MYHealer/wyu-jcalendar/assets/img/buymeacoffee.jpg

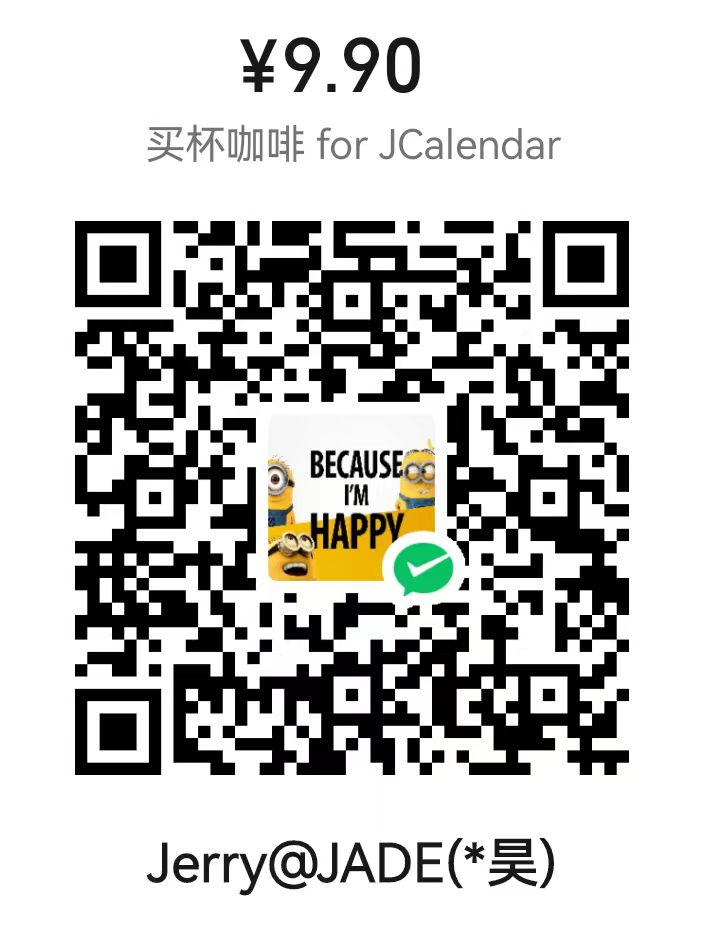
assets/img/buymeacoffee.jpg
