MYHealer/wyu-jcalendar/assets/img/likeit.jpg

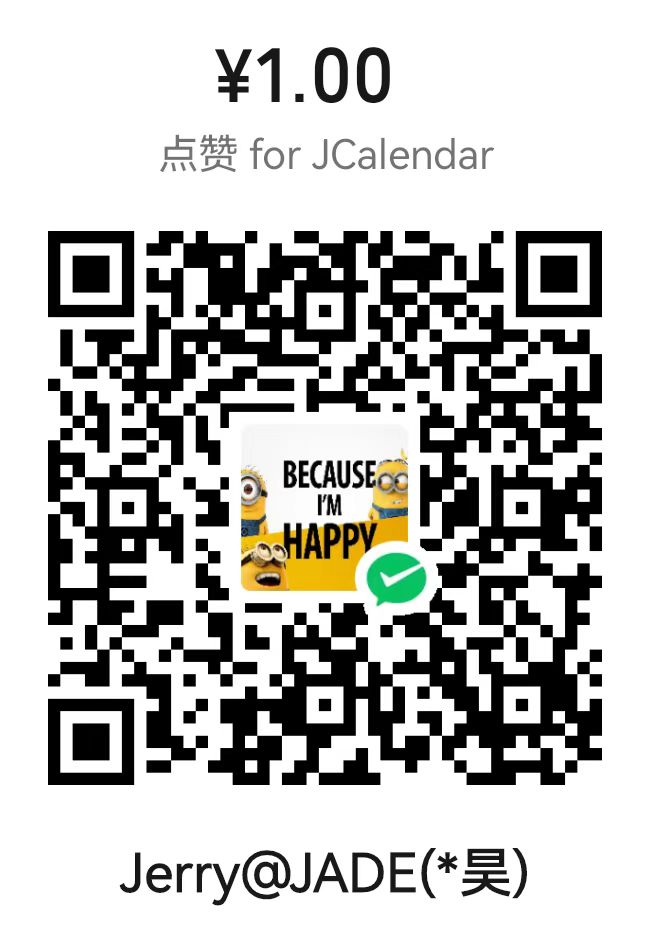
assets/img/likeit.jpg
