MYHealer/wyu-jcalendar/assets/img/LOLIN32_Lite.png

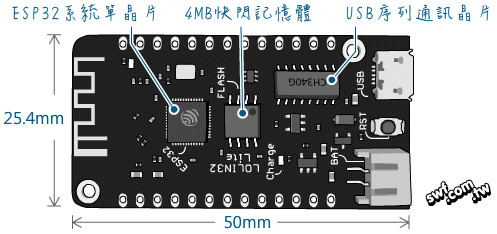
assets/img/LOLIN32_Lite.png
