MYHealer/wyu-jcalendar/assets/file/E-ink box2 v22.3mf

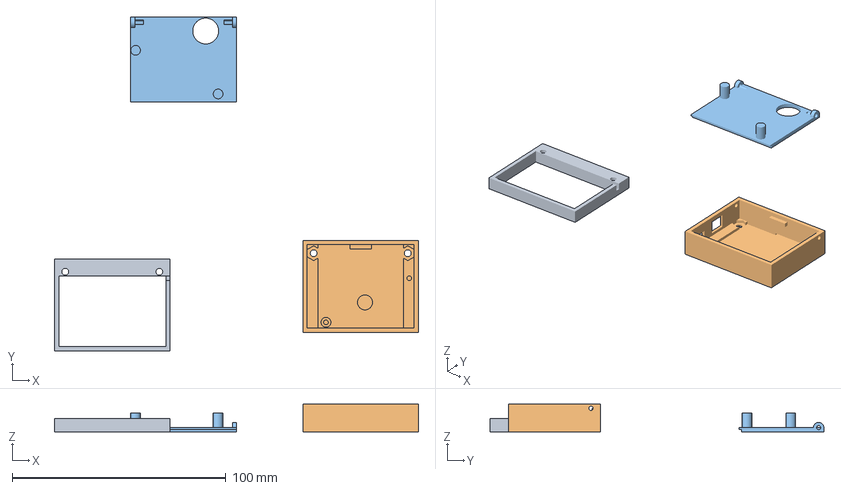
[picture p8: CAD file, 2026-05-20]
assets/file/E-ink box2 v22.3mf
170.1 x 156.0 x 13.0 mm
零部件3
零部件1
实体1.stl
