MYHealer/wyu-jcalendar/src/screen_ink.cpp

#include "screen_ink.h"


#include <weather.h>
#include <API.hpp>
#include "holiday.h"
#include "nongli.h"

#include "battery.h"
int voltage;

#include <_preference.h>

#include <U8g2_for_Adafruit_GFX.h>
#include <GxEPD2_3C.h>
#include "GxEPD2_display_selection_new_style.h"

#include "font.h"
#define ROTATION 0

#include "wiring.h"
GxEPD2_DISPLAY_CLASS<GxEPD2_DRIVER_CLASS, GxEPD2_DRIVER_CLASS::HEIGHT> display(GxEPD2_DRIVER_CLASS(/*CS=D8*/ SPI_CS, /*DC=D3*/ SPI_DC, /*RST=D4*/ SPI_RST, /*BUSY=D2*/ SPI_BUSY));
U8G2_FOR_ADAFRUIT_GFX u8g2Fonts;

#define FONT_TEXT u8g2_font_wqy16_t_gb2312 // 224825bytes，最大字库（天气描述中“霾”，只有此字库中有）
#define FONT_SUB u8g2_font_wqy12_t_gb2312 // 次要字体，u8g2最小字体
const String week_str[] = { "日", "一", "二", "三", "四", "五", "六" };
// const String tg_str[] = { "甲", "乙", "丙", "丁", "戊", "己", "庚", "辛", "壬", "癸" };            // 天干
// const String dz_str[] = { "子", "丑", "寅", "卯", "辰", "巳", "午", "未", "申", "酉", "戌", "亥" }; // 地支
// const String sx_str[] = { "鼠", "牛", "虎", "兔", "龙", "蛇", "马", "羊", "猴", "鸡", "狗", "猪" }; // 生肖
const String nl10_str[] = { "初", "十", "廿", "卅" }; // 农历十位
const String nl_str[] = { "十", "一", "二", "三", "四", "五", "六", "七", "八", "九", "十" }; // 农历个位
const String nl_mon_str[] = { "", "正", "二", "三", "四", "五", "六", "七", "八", "九", "十", "冬", "腊" }; // 农历首位

int _screen_status = -1;
int _calendar_status = -1;
String _cd_day_label;
String _cd_day_date;
String _tag_days_str;
int _week_1st;
int lunarDates[31];
int jqAccDate[24]; // 节气积累日

const int jrLength = 11;
const int jrDate[] = { 101, 214, 308, 312, 501, 504, 601, 701, 801, 910, 1001, 1224, 1225 };
const String jrText[] = { "元旦", "情人节", "妇女节", "植树节", "劳动节", "青年节", "儿童节", "建党节", "建军节", "教师节", "国庆节", "平安夜", "圣诞节" };

int _si_type = 0;
String _study_schedule;


struct tm tmInfo = { 0 }; // 日历显示用的时间

struct
{
    int16_t topX;
    int16_t topY;
    int16_t topW;
    int16_t topH;

    int16_t tX;
    int16_t tY;
    int16_t tW;
    int16_t tH;

    int16_t yearX;
    int16_t yearY;
    int16_t weekX;
    int16_t weekY;

    int16_t lunarYearX;
    int16_t lunarYearY;
    int16_t lunarDayX;
    int16_t lunarDayY;
    int16_t cdDayX;
    int16_t cdDayY;

    int16_t statusX;
    int16_t statusY;
    int16_t statusW;
    int16_t statusH;

    int16_t weatherX;
    int16_t weatherY;
    int16_t weatherW;
    int16_t weatherH;

    int16_t headerX;
    int16_t headerY;
    int16_t headerW;
    int16_t headerH;

    int16_t daysX;
    int16_t daysY;
    int16_t daysW;
    int16_t daysH;
    int16_t dayW;
    int16_t dayH;
} static calLayout;

TaskHandle_t SCREEN_HANDLER;

void init_cal_layout_size() {
    calLayout.topX = 0;
    calLayout.topY = 0;
    calLayout.topW = 180;
    calLayout.topH = 60;

    calLayout.yearX = 10;
    calLayout.yearY = calLayout.topH - 28;
    calLayout.weekX = 10;
    calLayout.weekY = calLayout.topH - 5;

    calLayout.lunarYearX = calLayout.topX + calLayout.topW + 15;
    calLayout.lunarYearY = calLayout.yearY / 2;
    calLayout.lunarDayX = calLayout.topX + calLayout.topW + 15;
    calLayout.lunarDayY = calLayout.yearY;

    calLayout.cdDayX = 0;
    calLayout.cdDayY = calLayout.topH - 5;

    calLayout.tX = calLayout.topX + calLayout.topW;
    calLayout.tY = calLayout.topY;
    calLayout.tW = 60;
    calLayout.tH = calLayout.topH / 2;

    calLayout.statusX = 300;
    calLayout.statusY = 0;
    calLayout.statusW = display.width() - calLayout.weatherX;
    calLayout.statusH = 14;

    calLayout.weatherX = 300;
    calLayout.weatherY = calLayout.topY;
    calLayout.weatherW = display.width() - calLayout.weatherX;
    calLayout.weatherH = calLayout.topH;

    calLayout.headerX = calLayout.topX;
    calLayout.headerY = calLayout.topY + calLayout.topH;
    calLayout.headerW = display.width();
    calLayout.headerH = 20;

    calLayout.daysX = calLayout.topX;
    calLayout.daysY = calLayout.headerY + calLayout.headerH;
    calLayout.daysW = calLayout.headerW;
    calLayout.daysH = display.height() - calLayout.daysX;
    calLayout.dayW = 56;
    calLayout.dayH = 44;
}

void draw_cal_header() {
    uint16_t color;

    u8g2Fonts.setFont(FONT_TEXT);
    u8g2Fonts.setFontMode(1);
    u8g2Fonts.setFontDirection(0);
    u8g2Fonts.setForegroundColor(GxEPD_WHITE);
    int16_t daysMagin = 4;

    for (int i = 0; i < 7; i++) {
        if ((i + _week_1st) % 7 == 0 || (i + _week_1st) % 7 == 6) {
            color = GxEPD_RED;
        } else {
            color = GxEPD_BLACK;
        }
        // header background
        if (i == 0) {
            display.fillRect(0, calLayout.headerY, (display.width() - 7 * calLayout.dayW) / 2, calLayout.headerH, color);
        } else if (i == 6) {
            display.fillRect((display.width() + 7 * calLayout.dayW) / 2, calLayout.headerY, (display.width() - 7 * calLayout.dayW) / 2, calLayout.headerH, color);
        }
        display.fillRect((display.width() - 7 * calLayout.dayW) / 2 + i * calLayout.dayW, calLayout.headerY, calLayout.dayW, calLayout.headerH, color);

        // header text
        u8g2Fonts.drawUTF8(calLayout.headerX + daysMagin + (calLayout.dayW - u8g2Fonts.getUTF8Width(week_str[i].c_str())) / 2 + i * calLayout.dayW, calLayout.headerY + calLayout.headerH - 3, week_str[(i + _week_1st) % 7].c_str());
    }
}

uint16_t todayColor = GxEPD_BLACK;
String todayLunarYear;
String todayLunarDay;

// 更新年份
void draw_cal_year(bool partial) {
    if (partial) {
        display.setPartialWindow(calLayout.topX, calLayout.topY, calLayout.topW + calLayout.tW, calLayout.topH);
        display.firstPage();
        display.fillScreen(GxEPD_WHITE);
    }

    // 日期
    u8g2Fonts.setFontMode(1);
    u8g2Fonts.setFontDirection(0);
    u8g2Fonts.setForegroundColor(todayColor);
    u8g2Fonts.setBackgroundColor(GxEPD_WHITE);
    u8g2Fonts.setCursor(calLayout.yearX, calLayout.yearY);
    u8g2Fonts.setFont(u8g2_font_fub25_tn);
    u8g2Fonts.print(String(tmInfo.tm_year + 1900).c_str());
    u8g2Fonts.setFont(FONT_TEXT);
    u8g2Fonts.setForegroundColor(GxEPD_BLACK);
    u8g2Fonts.print("年");
    u8g2Fonts.setFont(u8g2_font_fub25_tn);
    u8g2Fonts.setForegroundColor(todayColor);
    u8g2Fonts.print(String(tmInfo.tm_mon + 1).c_str());
    u8g2Fonts.setFont(FONT_TEXT);
    u8g2Fonts.setForegroundColor(GxEPD_BLACK);
    u8g2Fonts.print("月");
    u8g2Fonts.setFont(u8g2_font_fub25_tn);
    u8g2Fonts.setForegroundColor(todayColor);
    u8g2Fonts.printf(String(tmInfo.tm_mday).c_str());
    u8g2Fonts.setFont(FONT_TEXT);
    u8g2Fonts.setForegroundColor(GxEPD_BLACK);
    u8g2Fonts.print("日");

    calLayout.lunarYearX = u8g2Fonts.getCursorX() + 10;
    calLayout.lunarDayX = u8g2Fonts.getCursorX() + 10;

    // 第几周
    u8g2Fonts.setFont(FONT_TEXT);
    u8g2Fonts.setFontMode(1);
    u8g2Fonts.setFontDirection(0);
    u8g2Fonts.setForegroundColor(todayColor);
    u8g2Fonts.setCursor(calLayout.weekX, calLayout.weekY);
    char week_num[8];
    strftime(week_num, sizeof(week_num), "%V", &tmInfo); // 国际标准（ISO 8601）‌：以周一作为每周起始日
    u8g2Fonts.printf("第%s周", week_num);
    calLayout.cdDayX = u8g2Fonts.getCursorX(); // update cd day X;

    // 今日农历年份，e.g. 乙巳年 蛇
    // 如果农历月份小于公历月份，那么说明是上一年
    u8g2Fonts.setCursor(calLayout.lunarYearX, calLayout.lunarYearY);
    u8g2Fonts.setFont(FONT_SUB);
    u8g2Fonts.setFontMode(1);
    u8g2Fonts.setFontDirection(0);
    u8g2Fonts.setForegroundColor(GxEPD_BLACK);
    u8g2Fonts.print(todayLunarYear);

    // 今日农历日期
    u8g2Fonts.setCursor(calLayout.lunarDayX, calLayout.lunarDayY);
    u8g2Fonts.setFont(FONT_SUB);
    u8g2Fonts.setForegroundColor(GxEPD_BLACK);
    if (!todayLunarDay.isEmpty()) {
        u8g2Fonts.print(todayLunarDay);
    } else {
        u8g2Fonts.setFont(FONT_TEXT);
        u8g2Fonts.print(("星期" + week_str[tmInfo.tm_wday]).c_str());
    }

    // 特殊日期
    // draw_special_day();

    if (partial) {
        display.nextPage();
    }
}

void draw_cal_days(bool partial) {
    if (partial) {
        display.setPartialWindow(calLayout.daysX, calLayout.daysY, calLayout.daysW, calLayout.daysH);
        display.firstPage();
        display.fillScreen(GxEPD_WHITE);
    }

    u8g2Fonts.setFontMode(1);
    u8g2Fonts.setFontDirection(0);
    u8g2Fonts.setForegroundColor(GxEPD_BLACK);

    size_t totalDays = 30; // 小月
    int monthNum = tmInfo.tm_mon + 1;
    if (monthNum == 1 || monthNum == 3 || monthNum == 5 || monthNum == 7 || monthNum == 8 || monthNum == 10 || monthNum == 12) { // 大月
        totalDays = 31;
    }
    if (monthNum == 2) {
        if ((tmInfo.tm_year + 1900) % 4 == 0
            && (tmInfo.tm_year + 1900) % 100 != 0
            || (tmInfo.tm_year + 1900) % 400 == 0) {
            totalDays = 29; // 闰二月
        } else {
            totalDays = 28; // 二月
        }
    }

    // 计算本月第一天星期几
    int wday1 = (36 - tmInfo.tm_mday + tmInfo.tm_wday) % 7;
    // 计算本月第一天是全年的第几天（0～365）
    int yday1 = tmInfo.tm_yday - tmInfo.tm_mday + 1;

    // 确认哪些日期需要打tag
    char tags[31] = { 0 };
    int indexBegin = 0;
    while (_tag_days_str.length() >= (indexBegin + 9)) {
        String y = _tag_days_str.substring(indexBegin, indexBegin + 4);
        String m = _tag_days_str.substring(indexBegin + 4, indexBegin + 6);
        String d = _tag_days_str.substring(indexBegin + 6, indexBegin + 8);
        char t = _tag_days_str.charAt(indexBegin + 8);

        if ((y.equals(String(tmInfo.tm_year + 1900)) || y.equals("0000")) && (m.equals(String(tmInfo.tm_mon + 1)) || m.equals("00"))) {
            tags[d.toInt()] = t;
        }

        // Serial.printf("Format: %s, %s, %s, %c\n", y.c_str(), m.c_str(), d.c_str(), t);

        indexBegin = indexBegin + 9;
        while (indexBegin < _tag_days_str.length() && (_tag_days_str.charAt(indexBegin) < '0' || _tag_days_str.charAt(indexBegin) > '9')) { // 搜索字符串直到下个字符是0-9之间的
            indexBegin++;
        }
    }

    Holiday _holiday;
    Preferences pref;
    pref.begin(PREF_NAMESPACE);
    size_t holiday_size = pref.getBytesLength(PREF_HOLIDAY);
    if (holiday_size > 0) {
        pref.getBytes(PREF_HOLIDAY, &_holiday, holiday_size);
    }
    pref.end();

    if (_holiday.year != tmInfo.tm_year + 1900 || _holiday.month != tmInfo.tm_mon + 1) {
        _holiday = {};
    }

    int jqIndex = 0;
    int jrIndex = 0;
    int shiftDay = (wday1 - _week_1st) >= 0 ? 0 : 7;
    for (size_t iDay = 0; iDay < totalDays; iDay++) {
        uint8_t num = wday1 + iDay - _week_1st + shiftDay; // 根据每周首日星期做偏移
        uint8_t column = num % 7; //(0~6)
        uint8_t row = num / 7;    //(0~4)
        if (row == 5) row = 0;
        int16_t x = calLayout.daysX + 4 + column * 56;
        int16_t y = calLayout.daysY + row * 44;

        // 周六、日，字体红色
        uint16_t color;
        if ((wday1 + iDay) % 7 == 0 || (wday1 + iDay) % 7 == 6) {
            color = GxEPD_RED;
        } else {
            color = GxEPD_BLACK;
        }

        if (tmInfo.tm_year + 1900 == _holiday.year && tmInfo.tm_mon + 1 == _holiday.month) {
            uint8_t holidayIndex = 0;
            for (; holidayIndex < _holiday.length; holidayIndex++) {
                if (abs(_holiday.holidays[holidayIndex]) == (iDay + 1)) {
                    // 显示公休、调班logo和颜色
                    u8g2Fonts.setFont(u8g2_font_open_iconic_all_1x_t);
                    if (_holiday.holidays[holidayIndex] > 0) { // 公休
                        color = GxEPD_RED;
                        u8g2Fonts.setForegroundColor(color);
                        u8g2Fonts.setBackgroundColor(GxEPD_WHITE);
                        u8g2Fonts.drawUTF8(x + 44, y + 11, "\u006c");
                    } else if (_holiday.holidays[holidayIndex] < 0) { // 调班
                        color = GxEPD_BLACK;
                        u8g2Fonts.setForegroundColor(color);
                        u8g2Fonts.setBackgroundColor(GxEPD_WHITE);
                        u8g2Fonts.drawUTF8(x + 44, y + 11, "\u0064");
                    }
                    break;
                }
            }
        }
        u8g2Fonts.setForegroundColor(color); // 设置整体颜色
        u8g2Fonts.setBackgroundColor(GxEPD_WHITE);

        // 画日历日期数字
        u8g2Fonts.setFont(u8g2_font_fub17_tn); // u8g2_font_fub17_tn，u8g2_font_logisoso18_tn
        int16_t numX = x + (56 - u8g2Fonts.getUTF8Width(String(iDay + 1).c_str())) / 2;
        int16_t numY = y + 22;
        u8g2Fonts.drawUTF8(numX, numY, String(iDay + 1).c_str()); // 画日历日期

        // 画节气&节日&农历       
        String lunarStr = "";
        int lunarDate = lunarDates[iDay];
        int isLeapMon = lunarDate < 0 ? 1 : 0; // 闰月
        lunarDate = abs(lunarDate);
        int lunarMon = lunarDate / 100;
        int lunarDay = lunarDate % 100;

        bool isJq = false; // 是否节气
        int accDays0 = tmInfo.tm_yday + 1 - tmInfo.tm_mday; // 本月0日的积累日（tm_yday 从0开始，tm_mday从1开始, i从0开始）
        for (; jqIndex < 24; jqIndex++) {
            if (accDays0 + iDay + 1 < jqAccDate[jqIndex]) {
                break;
            }
            if (accDays0 + iDay + 1 == jqAccDate[jqIndex]) {
                lunarStr = String(nl_jq_text[jqIndex]);
                isJq = true;
                break;
            }
        }
        bool isJr = false; // 是否节日
        int currentDateNum = (tmInfo.tm_mon + 1) * 100 + iDay + 1;
        for (; jrIndex < jrLength; jrIndex++) {
            if (currentDateNum < jrDate[jrIndex]) {
                break;
            }
            if (currentDateNum == jrDate[jrIndex]) {
                lunarStr = jrText[jrIndex];
                isJr = true;
                break;
            }
        }
        if (!isJq && !isJr) { // 农历
            if (lunarDay == 1) {
                // 初一，显示月份
                lunarStr = (isLeapMon == 0 ? "" : "闰") + nl_mon_str[lunarMon] + "月";
            } else {
                if (lunarDay == 10) {
                    lunarStr = "初十";
                } else if (lunarDay == 20) {
                    lunarStr = "二十";
                } else if (lunarDay == 30) {
                    lunarStr = "三十";
                } else {
                    // 其他日期
                    lunarStr = nl10_str[lunarDay / 10] + nl_str[lunarDay % 10];
                }
            }
            if (lunarMon == 1 && lunarDay == 1) {
                lunarStr = "春节";
            } else if (lunarMon == 1 && lunarDay == 15) {
                lunarStr = "元宵节";
            } else if (lunarMon == 5 && lunarDay == 5) {
                lunarStr = "端午节";
            } else if (lunarMon == 7 && lunarDay == 7) {
                lunarStr = "七夕节";
            } else if (lunarMon == 8 && lunarDay == 15) {
                lunarStr = "中秋节";
            } else if (lunarMon == 9 && lunarDay == 9) {
                lunarStr = "重阳节";
            }
        }
        // 画节气/节日/农历文字
        u8g2Fonts.setFont(FONT_TEXT);
        u8g2Fonts.drawUTF8(x + (56 - u8g2Fonts.getUTF8Width(lunarStr.c_str())) / 2, y + 44 - 4, lunarStr.c_str());

        // 今日日期
        if ((iDay + 1) == tmInfo.tm_mday) { // 双线加粗
            todayColor = color;

            // 加框线
            display.drawRoundRect(x, y + 1, 56, 44, 4, GxEPD_RED);
            display.drawRoundRect(x + 1, y + 2, 54, 42, 3, GxEPD_RED);

            // 今日农历年份，e.g. 乙巳年 蛇
            // 如果农历月份小于公历月份，那么说明是上一年
            int tg = nl_tg(tmInfo.tm_year + 1900 - (lunarMon > (tmInfo.tm_mon + 1) ? 1 : 0));
            int dz = nl_dz(tmInfo.tm_year + 1900 - (lunarMon > (tmInfo.tm_mon + 1) ? 1 : 0));;
            todayLunarYear = String(nl_tg_text[tg]) + String(nl_dz_text[dz]) + "年 " + String(nl_sx_text[dz]);

            // 今日农历日期
            if (lunarDay == 10) {
                lunarStr = "初十";
            } else if (lunarDay == 20) {
                lunarStr = "二十";
            } else if (lunarDay == 30) {
                lunarStr = "三十";
            } else {
                // 其他日期
                lunarStr = nl10_str[lunarDay / 10] + nl_str[lunarDay % 10];
            }
            todayLunarDay = (isLeapMon == 0 ? "" : "闰") + nl_mon_str[lunarMon] + "月" + lunarStr;
        }

        // 画日期Tag
        const char* tagChar = NULL;
        if (tags[iDay + 1] == 'a') { //tag
            tagChar = "\u0042";
        } else if (tags[iDay + 1] == 'b') { // dollar
            tagChar = "\u0024";
        } else if (tags[iDay + 1] == 'c') { // smile
            tagChar = "\u0053";
        } else if (tags[iDay + 1] == 'd') { // warning
            tagChar = "\u0021";
        }
        if (tagChar != NULL) {
            u8g2Fonts.setBackgroundColor(GxEPD_WHITE);
            u8g2Fonts.setForegroundColor(GxEPD_RED);
            u8g2Fonts.setFont(u8g2_font_twelvedings_t_all);
            int iconX = numX - u8g2Fonts.getUTF8Width(tagChar) - 1; // 数字与tag间间隔1像素
            iconX = iconX <= (x + 3) ? (iconX + 1) : iconX; // 防止icon与今日框线产生干涉。
            int iconY = y + 15;
            u8g2Fonts.drawUTF8(iconX, iconY, tagChar);
        }

        // 画Calendar提示点
        /*
        Calendar* cal = weather_cal();
        for(int calIndex = 0; calIndex < cal->length; calIndex ++) {
            CalEvent event = cal->events[calIndex];
            if(event.dt_begin.substring(0, 4).toInt() == (tmInfo.tm_year + 1900)
            && event.dt_begin.substring(4, 6).toInt() == (tmInfo.tm_mon + 1)
            && event.dt_begin.substring(6, 8).toInt() == (iDay + 1)) {
                u8g2Fonts.setBackgroundColor(GxEPD_WHITE);
                u8g2Fonts.setForegroundColor(GxEPD_RED);
                u8g2Fonts.setFont(u8g2_font_siji_t_6x10);
                u8g2Fonts.drawUTF8(x + 42, y + 12, "\ue015");
            }
        }
        */
    }
}

// draw countdown-day info
void draw_cd_day(String label, String date) {
    if (label == NULL || date == NULL || label.length() == 0 || date.length() != 8) {
        Serial.print("Invalid countdown-day parameters.\n");
        return;
    }

    long d = atol(date.c_str());

    struct tm today = { 0 }; // 今日0秒
    today.tm_year = tmInfo.tm_year;
    today.tm_mon = tmInfo.tm_mon;
    today.tm_mday = tmInfo.tm_mday;
    today.tm_hour = 0;
    today.tm_min = 0;
    today.tm_sec = 0;
    time_t todayT = mktime(&today);

    struct tm someday = { 0 }; // 倒计日0秒
    someday.tm_year = d / 10000 - 1900;
    someday.tm_mon = d % 10000 / 100 - 1;
    someday.tm_mday = d % 100;
    someday.tm_hour = 0;
    someday.tm_min = 0;
    someday.tm_sec = 0;
    time_t somedayT = mktime(&someday);

    /*
    char buffer[80];
    strftime(buffer, 80, "%Y-%m-%d %H:%M:%S", &someday);
    Serial.printf("CD day: %s\n", buffer);
    */

    long diff = somedayT - todayT;
    if (diff < 0) return; // 倒计日已过

    int16_t beginX = calLayout.cdDayX;
    int16_t endX = calLayout.weatherX;
    int16_t y = calLayout.cdDayY;

    if (diff == 0) {
        String prefix = "今日 ";
        String suffix = " ！！！";
        u8g2Fonts.setFont(FONT_SUB);
        int16_t preWidth = u8g2Fonts.getUTF8Width(prefix.c_str());
        int16_t suffixWidth = u8g2Fonts.getUTF8Width(suffix.c_str());
        u8g2Fonts.setFont(FONT_SUB);
        int16_t labelWidth = u8g2Fonts.getUTF8Width(label.c_str());
        int16_t margin = (endX - beginX - preWidth - labelWidth - suffixWidth) / 2;

        u8g2Fonts.setCursor((margin > 0 ? margin : 0) + beginX, y); // 居中显示
        u8g2Fonts.setForegroundColor(GxEPD_BLACK);
        u8g2Fonts.setFont(FONT_SUB);
        u8g2Fonts.print(prefix.c_str()); // 今天
        u8g2Fonts.setForegroundColor(GxEPD_RED);
        u8g2Fonts.setFont(FONT_TEXT);
        u8g2Fonts.print(label.c_str()); // ****
        u8g2Fonts.setForegroundColor(GxEPD_BLACK);
        u8g2Fonts.setFont(FONT_SUB);
        u8g2Fonts.print(suffix.c_str()); // ！
    } else if (diff > 0) {
        String prefix = "距 ";
        String middle = " 还有 ";
        int iDiff = diff / (60 * 60 * 24);
        char days[11] = "";
        itoa(iDiff, days, 10);
        String suffix = " 天";

        u8g2Fonts.setFont(FONT_SUB);
        int16_t preWidth = u8g2Fonts.getUTF8Width(prefix.c_str());
        int16_t midWidth = u8g2Fonts.getUTF8Width(middle.c_str());
        int16_t suffixWidth = u8g2Fonts.getUTF8Width(suffix.c_str());
        u8g2Fonts.setFont(FONT_SUB);
        int16_t labelWidth = u8g2Fonts.getUTF8Width(label.c_str());
        u8g2Fonts.setFont(u8g2_font_fub14_tn);
        int16_t daysWidth = u8g2Fonts.getUTF8Width(days);
        int16_t margin = (endX - beginX - preWidth - labelWidth - midWidth - daysWidth - suffixWidth) / 2;

        u8g2Fonts.setCursor((margin > 0 ? margin : 0) + beginX, y); // 居中显示
        u8g2Fonts.setForegroundColor(GxEPD_BLACK);
        u8g2Fonts.setFont(FONT_SUB);
        u8g2Fonts.print(prefix.c_str()); // 距
        u8g2Fonts.setFont(FONT_TEXT);
        u8g2Fonts.print(label.c_str()); // ****
        u8g2Fonts.setFont(FONT_SUB);
        u8g2Fonts.print(middle.c_str()); // 还有
        u8g2Fonts.setForegroundColor(GxEPD_RED);
        u8g2Fonts.setFont(u8g2_font_fub14_tn);
        u8g2Fonts.print(days); // 0000
        u8g2Fonts.setForegroundColor(GxEPD_BLACK);
        u8g2Fonts.setFont(FONT_SUB);
        u8g2Fonts.print(suffix.c_str()); // 天
    }
}


void draw_special_day() {
    String str = "Special Days!!!";

    u8g2Fonts.setCursor(u8g2Fonts.getCursorX() + 12, u8g2Fonts.getCursorY());
    u8g2Fonts.setForegroundColor(GxEPD_RED);
    u8g2Fonts.setFont(u8g2_font_open_iconic_all_2x_t);
    u8g2Fonts.print("\u00b7"); // 爱心
    u8g2Fonts.setFont(FONT_TEXT);
    u8g2Fonts.setForegroundColor(GxEPD_BLACK);
    u8g2Fonts.print(str.c_str());
    u8g2Fonts.setForegroundColor(GxEPD_RED);
    u8g2Fonts.setFont(u8g2_font_open_iconic_all_2x_t);
    u8g2Fonts.print("\u00b7"); // 爱心
}

bool isNight(String time) {
    uint8_t hour = time.substring(11, 13).toInt();
    return hour < 6 || hour >= 18;
}

const char* getWeatherIcon(uint16_t id, bool fill) {
    switch (id) {
    case 100: return !fill ? "\uf101" : "\uf1ac";
    case 101: return !fill ? "\uf102" : "\uf1ad";
    case 102: return !fill ? "\uf103" : "\uf1ae";
    case 103: return !fill ? "\uf104" : "\uf1af";
    case 104: return !fill ? "\uf105" : "\uf1b0";
    case 150: return !fill ? "\uf106" : "\uf1b1";
    case 151: return !fill ? "\uf107" : "\uf1b2";
    case 152: return !fill ? "\uf108" : "\uf1b3";
    case 153: return !fill ? "\uf109" : "\uf1b4";
    case 300: return !fill ? "\uf10a" : "\uf1b5";
    case 301: return !fill ? "\uf10b" : "\uf1b6";
    case 302: return !fill ? "\uf10c" : "\uf1b7";
    case 303: return !fill ? "\uf10d" : "\uf1b8";
    case 304: return !fill ? "\uf10e" : "\uf1b9";
    case 305: return !fill ? "\uf10f" : "\uf1ba";
    case 306: return !fill ? "\uf110" : "\uf1bb";
    case 307: return !fill ? "\uf111" : "\uf1bc";
    case 308: return !fill ? "\uf112" : "\uf1bd";
    case 309: return !fill ? "\uf113" : "\uf1be";
    case 310: return !fill ? "\uf114" : "\uf1bf";
    case 311: return !fill ? "\uf115" : "\uf1c0";
    case 312: return !fill ? "\uf116" : "\uf1c1";
    case 313: return !fill ? "\uf117" : "\uf1c2";
    case 314: return !fill ? "\uf118" : "\uf1c3";
    case 315: return !fill ? "\uf119" : "\uf1c4";
    case 316: return !fill ? "\uf11a" : "\uf1c5";
    case 317: return !fill ? "\uf11b" : "\uf1c6";
    case 318: return !fill ? "\uf11c" : "\uf1c7";
    case 350: return !fill ? "\uf11d" : "\uf1c8";
    case 351: return !fill ? "\uf11e" : "\uf1c9";
    case 399: return !fill ? "\uf11f" : "\uf1ca";
    case 400: return !fill ? "\uf120" : "\uf1cb";
    case 401: return !fill ? "\uf121" : "\uf1cc";
    case 402: return !fill ? "\uf122" : "\uf1cd";
    case 403: return !fill ? "\uf123" : "\uf1ce";
    case 404: return !fill ? "\uf124" : "\uf1cf";
    case 405: return !fill ? "\uf125" : "\uf1d0";
    case 406: return !fill ? "\uf126" : "\uf1d1";
    case 407: return !fill ? "\uf127" : "\uf1d2";
    case 408: return !fill ? "\uf128" : "\uf1d3";
    case 409: return !fill ? "\uf129" : "\uf1d4";
    case 410: return !fill ? "\uf12a" : "\uf1d5";
    case 456: return !fill ? "\uf12b" : "\uf1d6";
    case 457: return !fill ? "\uf12c" : "\uf1d7";
    case 499: return !fill ? "\uf12d" : "\uf1d8";
    case 500: return !fill ? "\uf12e" : "\uf1d9";
    case 501: return !fill ? "\uf12f" : "\uf1da";
    case 502: return !fill ? "\uf130" : "\uf1db";
    case 503: return !fill ? "\uf131" : "\uf1dc";
    case 504: return !fill ? "\uf132" : "\uf1dd";
    case 507: return !fill ? "\uf133" : "\uf1de";
    case 508: return !fill ? "\uf134" : "\uf1df";
    case 509: return !fill ? "\uf135" : "\uf1e0";
    case 510: return !fill ? "\uf136" : "\uf1e1";
    case 511: return !fill ? "\uf137" : "\uf1e2";
    case 512: return !fill ? "\uf138" : "\uf1e3";
    case 513: return !fill ? "\uf139" : "\uf1e4";
    case 514: return !fill ? "\uf13a" : "\uf1e5";
    case 515: return !fill ? "\uf13b" : "\uf1e6";
    case 800: return "\uf13c";
    case 801: return "\uf13d";
    case 802: return "\uf13e";
    case 803: return "\uf13f";
    case 804: return "\uf140";
    case 805: return "\uf141";
    case 806: return "\uf142";
    case 807: return "\uf143";
    case 900: return !fill ? "\uf144" : "\uf1e7";
    case 901: return !fill ? "\uf145" : "\uf1e8";
    case 999:
    default: return !fill ? "\uf146" : "\uf1e9";
    }
}

// 画天气信息
#include "API.hpp"
void draw_weather(bool partial) {
    if (partial) {
        display.setPartialWindow(calLayout.weatherX, calLayout.weatherY, calLayout.weatherW, calLayout.weatherH - 1); // 高度减1，防止干扰到其他区域颜色
        display.firstPage();
        display.fillScreen(GxEPD_WHITE);
    }

    u8g2Fonts.setFontMode(1);
    u8g2Fonts.setFontDirection(0);
    u8g2Fonts.setForegroundColor(GxEPD_BLACK);
    u8g2Fonts.setBackgroundColor(GxEPD_WHITE);
    if (weather_type() == 1) {
        // 实时天气
        Weather* wNow = weather_data_now();
        /* 更新排版，将字体缩小，与每日天气风格一致
        // 天气图标
        u8g2Fonts.setFont(u8g2_font_qweather_icon_16);
        u8g2Fonts.setCursor(calLayout.weatherX + 2, calLayout.weatherY + 30);
        u8g2Fonts.print(getWeatherIcon(wNow->icon, isNight(wNow->time)));

        // 天气文字
        u8g2Fonts.setFont(FONT_TEXT);
        uint16_t w1 = u8g2Fonts.getUTF8Width(wNow->text.c_str());
        u8g2Fonts.setCursor(calLayout.weatherX + 30, calLayout.weatherY + 18);
        u8g2Fonts.print((wNow->text).c_str());

        // 温湿度
        u8g2Fonts.setFont(u8g2_font_tenthinnerguys_tf);
        u8g2Fonts.setCursor(calLayout.weatherX + 30, calLayout.weatherY + 35);
        u8g2Fonts.printf("%d°C | %d%%", wNow->temp, wNow->humidity);

        // 风向级别
        u8g2Fonts.setCursor(calLayout.weatherX, calLayout.weatherY + calLayout.weatherH - 6);
        u8g2Fonts.setFont(FONT_TEXT);
        u8g2Fonts.printf("%s", wNow->windDir.c_str());
        u8g2Fonts.setFont(u8g2_font_fub14_tn);
        u8g2Fonts.printf(" %d ", wNow->windScale);
        u8g2Fonts.setFont(FONT_TEXT);
        u8g2Fonts.printf("级");
        */
        // 天气图标
        u8g2Fonts.setFont(u8g2_font_qweather_icon_16);
        u8g2Fonts.setCursor(calLayout.weatherX, calLayout.weatherY + 44);
        u8g2Fonts.print(getWeatherIcon(wNow->icon, isNight(wNow->time)));

        // 天气文字
        u8g2Fonts.setFont(FONT_SUB);
        uint16_t w1 = u8g2Fonts.getUTF8Width(wNow->text.c_str());
        u8g2Fonts.setCursor(calLayout.weatherX + 28, calLayout.weatherY + 22);
        u8g2Fonts.print(wNow->text.c_str());

        u8g2Fonts.setFont(u8g2_font_tenthinnerguys_tf);
        u8g2Fonts.setCursor(calLayout.weatherX + 28, calLayout.weatherY + 37);
        u8g2Fonts.printf("%d°C | %d%%", wNow->temp, wNow->humidity);

        // 风向级别
        u8g2Fonts.setCursor(calLayout.weatherX + 28, calLayout.weatherY + calLayout.weatherH - 6);
        u8g2Fonts.setFont(FONT_SUB);
        u8g2Fonts.printf("%s", wNow->windDir.c_str());
        u8g2Fonts.setCursor(u8g2Fonts.getCursorX() + 5, u8g2Fonts.getCursorY());
        u8g2Fonts.setFont(u8g2_font_tenthinnerguys_tf);
        u8g2Fonts.printf("%d", wNow->windScale);
        u8g2Fonts.setCursor(u8g2Fonts.getCursorX() + 5, u8g2Fonts.getCursorY());
        u8g2Fonts.setFont(FONT_SUB);
        u8g2Fonts.printf("级");
    } else {
        // 每日天气
        DailyForecast* wFc = weather_data_daily();
        DailyWeather* dw = wFc->weather;
        if (wFc->length == 0) {
            return;
        }
        DailyWeather wToday = dw[0];

        // 天气图标
        u8g2Fonts.setFont(u8g2_font_qweather_icon_16);
        u8g2Fonts.setCursor(calLayout.weatherX, calLayout.weatherY + 44);
        u8g2Fonts.print(getWeatherIcon(wToday.iconDay, false));

        // 天气文字
        u8g2Fonts.setFont(FONT_SUB);
        uint16_t w1 = u8g2Fonts.getUTF8Width(wToday.textDay.c_str());
        u8g2Fonts.setCursor(calLayout.weatherX + 28, calLayout.weatherY + 22);
        u8g2Fonts.print((wToday.textDay).c_str());

        u8g2Fonts.setFont(u8g2_font_tenthinnerguys_tf);
        u8g2Fonts.setCursor(u8g2Fonts.getCursorX() + 5, calLayout.weatherY + 22);
        u8g2Fonts.printf("%d%%", wToday.humidity);

        // 温度
        u8g2Fonts.setFont(u8g2_font_tenthinnerguys_tf);
        u8g2Fonts.setCursor(calLayout.weatherX + 28, calLayout.weatherY + 37);
        u8g2Fonts.printf("%d - %d°C", wToday.tempMin, wToday.tempMax);

        // 风向级别
        u8g2Fonts.setCursor(calLayout.weatherX + 28, calLayout.weatherY + calLayout.weatherH - 6);
        u8g2Fonts.setFont(FONT_SUB);
        u8g2Fonts.printf("%s", wToday.windDirDay.c_str());
        u8g2Fonts.setFont(u8g2_font_tenthinnerguys_tf);
        u8g2Fonts.printf(" %d ", wToday.windScaleDay);
        u8g2Fonts.setFont(FONT_SUB);
        u8g2Fonts.printf("级");
    }

    if (partial) {
        display.nextPage();
    }
}

// Draw err
void draw_err(bool partial) {
    if (partial) {
        display.setPartialWindow(380, 0, 20, 20);
        display.firstPage();
        display.fillScreen(GxEPD_WHITE);
    }
    u8g2Fonts.setFontMode(1);
    u8g2Fonts.setFontDirection(0);
    u8g2Fonts.setBackgroundColor(GxEPD_WHITE);
    u8g2Fonts.setForegroundColor(GxEPD_RED);
    u8g2Fonts.setFont(u8g2_font_open_iconic_all_2x_t);
    u8g2Fonts.setCursor(382, 18);
    u8g2Fonts.print("\u0118");

    if (partial) {
        display.nextPage();
    }
}

void draw_status(bool partial) {
    if (partial) {
        display.setPartialWindow(calLayout.statusX, calLayout.statusY, calLayout.statusW, calLayout.statusH);
        display.firstPage();
        display.fillScreen(GxEPD_WHITE);
    }
    u8g2Fonts.setFontMode(1);
    u8g2Fonts.setFontDirection(0);
    u8g2Fonts.setBackgroundColor(GxEPD_WHITE);
    u8g2Fonts.setForegroundColor(GxEPD_BLACK);
    u8g2Fonts.setFont(u8g2_font_siji_t_6x10);

    // 电池icon
    String iconStr = "";
    if(voltage >= 4100) { // 满电
        iconStr = "\ue24b";
    } else if (voltage >= 3900) { // 多电
        iconStr = "\ue249";
    } else if (voltage >= 3700) { // 中电量
        iconStr = "\ue247";
    } else if (voltage >= 3500) { // 低电量
        iconStr = "\ue245";
    } else { // 空
        iconStr = "\ue242";
    }
    u8g2Fonts.drawUTF8(400 - 12 - 4, 10, iconStr.c_str());

    if (partial) {
        display.nextPage();
    }
}

void drawStudySchedule() {
    int i = _study_schedule.substring(0, 3).toInt();
    Serial.printf("%d\r\n", i);
    int morningClassCount = i / 100;
    int eveningClassCount = (i % 100) / 10;
    int nightClassCount = i % 10;
    int segmentCount = (morningClassCount > 0 ? 1 : 0) + (eveningClassCount > 0 ? 1 : 0) + (nightClassCount > 0 ? 1 : 0);
    String daysClassStr[7];
    int pos_begin = 4;
    int daysCount = 0;
    do {
        int pos_end = _study_schedule.indexOf(";", pos_begin);
        if (pos_end < 0) break;

        String str = _study_schedule.substring(pos_begin, pos_end);
        str.trim();
        daysClassStr[daysCount++] = str;
        // Serial.printf("%d : %d : %s\r\n", daysCount, pos_end, str.c_str());
        pos_begin = pos_end + 1;
    } while (true);

    // 计算Cell尺寸
    int cellHeight = (display.height() - calLayout.topH - calLayout.headerH - segmentCount * 2) / (morningClassCount + eveningClassCount + nightClassCount);
    int cellWidth = display.width() / daysCount;
    int marginLeft = (display.width() - cellWidth * daysCount) / 2;

    // cell line
    display.drawFastHLine(0, calLayout.topH, display.width(), GxEPD_RED);
    display.drawFastHLine(0, calLayout.topH - 1, display.width(), GxEPD_RED);
    display.drawFastHLine(0, calLayout.topH + calLayout.headerH - 1, display.width(), GxEPD_RED);
    display.drawFastHLine(0, calLayout.topH + calLayout.headerH, display.width(), GxEPD_RED);
    int segmentIndex = 0;
    uint16_t max_y = calLayout.topH + calLayout.headerH; // 水平分割线
    for (int x = 1; x <= morningClassCount; x++) {
        max_y += cellHeight;
        display.drawFastHLine(0, max_y, display.width(), GxEPD_BLACK);
    }
    if (eveningClassCount > 0) {
        max_y += 2;
        display.drawFastHLine(0, max_y, display.width(), GxEPD_BLACK);
    }
    for (int x = 1; x <= eveningClassCount; x++) {
        max_y += cellHeight;
        display.drawFastHLine(0, max_y, display.width(), GxEPD_BLACK);
    }
    if (nightClassCount > 0) {
        max_y += 2;
        display.drawFastHLine(0, max_y, display.width(), GxEPD_BLACK);
    }
    for (int x = 1; x <= nightClassCount; x++) {
        max_y += cellHeight;
        display.drawFastHLine(0, max_y, display.width(), GxEPD_BLACK);
    }
    for (int x = 1; x < daysCount; x++) { // 垂直分割线
        display.drawFastVLine(cellWidth * x, calLayout.headerH + calLayout.topH, max_y - calLayout.headerH - calLayout.topH, GxEPD_BLACK);
    }

    for (int x = 0; x < daysCount; x++) {
        // Serial.println(daysClassStr[x].c_str());
        int pos_begin = 0;
        int yStep = 0;
        int segmentIndex = 0;


        uint16_t fontColor = GxEPD_BLACK;
        do {
            int pos_end = daysClassStr[x].indexOf(",", pos_begin);
            String ss = daysClassStr[x].substring(pos_begin, pos_end);
            ss.trim();
            // Serial.printf("%s\r\n", ss.c_str());
            // 课名超过12个字符时截断为11个字符+省略号
            {
                int charCount = 0;
                int byteIdx = 0;
                int lastByteIdx = 0; // 第11个字符的结束位置
                while (byteIdx < ss.length() && charCount < 12) {
                    unsigned char c = ss[byteIdx];
                    int charLen = 1;
                    if ((c & 0x80) == 0x00) charLen = 1;
                    else if ((c & 0xE0) == 0xC0) charLen = 2;
                    else if ((c & 0xF0) == 0xE0) charLen = 3;
                    else if ((c & 0xF8) == 0xF0) charLen = 4;
                    if (charCount < 11) lastByteIdx = byteIdx + charLen;
                    byteIdx += charLen;
                    charCount++;
                }
                if (byteIdx < ss.length()) {
                    ss = ss.substring(0, lastByteIdx) + "...";
                }
            }
                        if (yStep == 0) {
                if (week_str[tmInfo.tm_wday] == ss) {
                    display.fillRect(cellWidth * x + marginLeft, calLayout.topH, cellWidth, calLayout.headerH, GxEPD_RED);
                    fontColor = GxEPD_RED;
                    u8g2Fonts.setBackgroundColor(GxEPD_RED);
                    u8g2Fonts.setForegroundColor(GxEPD_WHITE);
                } else {
                    fontColor = GxEPD_BLACK;
                    u8g2Fonts.setBackgroundColor(GxEPD_WHITE);
                    u8g2Fonts.setForegroundColor(fontColor);
                }
                u8g2Fonts.setFont(FONT_TEXT);
                u8g2Fonts.drawUTF8(cellWidth * x + marginLeft + (cellWidth - u8g2Fonts.getUTF8Width(ss.c_str())) / 2, calLayout.topH + calLayout.headerH - 4, ss.c_str());
            } else if (yStep > 0) {
                if (yStep == morningClassCount + 1 || yStep == (morningClassCount + eveningClassCount + 1)) {
                    segmentIndex++;
                }
                u8g2Fonts.setBackgroundColor(GxEPD_WHITE);
                u8g2Fonts.setForegroundColor(fontColor);

                                                                                // 自适应字体+自动换行：逐级尝试，保证文字完整显示
                int availW = cellWidth - 4; // 留2px左右边距
                // 格子顶部Y坐标（基准点）
                int cellTop = calLayout.topH + calLayout.headerH + cellHeight * (yStep - 1) + 2 * segmentIndex;
                int len = ss.length();

                // 辅助函数：按像素宽度找断行点，返回断点字节位置数组
                // lines: 输出每行字符串数组, maxLines: 最多行数
                auto splitToLines = [&](const String& text, int maxLines, String* lines, int& lineCount) {
                    lineCount = 0;
                    int remaining = text.length();
                    int pos = 0;
                    for (int line = 0; line < maxLines && remaining > 0; line++) {
                        if (line == maxLines - 1) {
                            // 最后一行，直接取剩余全部
                            lines[lineCount++] = text.substring(pos);
                            break;
                        }
                        // 从后往前找断行点
                        int bestBreak = pos + remaining;
                        for (int ci = pos + remaining - 1; ci > pos; ci--) {
                            if ((text[ci] & 0xC0) == 0x80) continue; // 跳过续字节
                            String sub = text.substring(pos, ci);
                            if (u8g2Fonts.getUTF8Width(sub.c_str()) <= availW) {
                                bestBreak = ci;
                                break;
                            }
                        }
                        lines[lineCount++] = text.substring(pos, bestBreak);
                        remaining -= (bestBreak - pos);
                        pos = bestBreak;
                    }
                };

                // 尝试策略：16px单行 → 12px单行 → 12px双行 → 12px三行 → 截断省略号
                bool drawn = false;

                // 策略1: 16px单行
                u8g2Fonts.setFont(FONT_TEXT);
                int textW = u8g2Fonts.getUTF8Width(ss.c_str());
                if (textW <= availW) {
                    int drawY = cellTop + (cellHeight + 16) / 2 - 3;
                    u8g2Fonts.drawUTF8(cellWidth * x + marginLeft + (availW - textW) / 2, drawY, ss.c_str());
                    drawn = true;
                }

                // 策略2: 12px单行
                if (!drawn) {
                    u8g2Fonts.setFont(FONT_SUB);
                    textW = u8g2Fonts.getUTF8Width(ss.c_str());
                    if (textW <= availW) {
                        int drawY = cellTop + (cellHeight + 12) / 2 - 2;
                        u8g2Fonts.drawUTF8(cellWidth * x + marginLeft + (availW - textW) / 2, drawY, ss.c_str());
                        drawn = true;
                    }
                }

                // 策略3-4: 12px多行（2行或3行）
                if (!drawn) {
                    String lines[3];
                    int lineCount = 0;
                    // 先尝试2行
                    splitToLines(ss, 2, lines, lineCount);
                    bool twoLineOk = (lineCount == 2);
                    if (twoLineOk) {
                        for (int li = 0; li < lineCount; li++) {
                            if (u8g2Fonts.getUTF8Width(lines[li].c_str()) > availW) {
                                twoLineOk = false;
                                break;
                            }
                        }
                    }

                    if (!twoLineOk && cellHeight >= 40) {
                        // 2行塞不下，尝试3行
                        splitToLines(ss, 3, lines, lineCount);
                    }

                                        if (lineCount >= 2) {
                        int fontH = 12;
                        int lineSpacing = 2;
                        int totalH = fontH * lineCount + lineSpacing * (lineCount - 1);
                        int textTop = cellTop + (cellHeight - totalH) / 2;
                        int ascent = 10;
                        for (int li = 0; li < lineCount; li++) {
                            int lw = u8g2Fonts.getUTF8Width(lines[li].c_str());
                            // 用格子实际宽度居中，而非availW
                            int lx = (lw < cellWidth) ? (cellWidth - lw) / 2 : 2;
                            int ly = textTop + li * (fontH + lineSpacing) + ascent;
                            u8g2Fonts.drawUTF8(cellWidth * x + marginLeft + lx, ly, lines[li].c_str());
                        }
                        drawn = true;
                    }
                }

                // 策略5: 最终兜底截断
                if (!drawn) {
                    u8g2Fonts.setFont(FONT_SUB);
                    String drawStr = ss;
                    while (drawStr.length() > 1) {
                        int lastIdx = drawStr.length() - 1;
                        while (lastIdx > 0 && (drawStr[lastIdx] & 0xC0) == 0x80) lastIdx--;
                        drawStr = drawStr.substring(0, lastIdx);
                        textW = u8g2Fonts.getUTF8Width((drawStr + "..").c_str());
                        if (textW <= availW) {
                            drawStr = drawStr + "..";
                            break;
                        }
                    }
                    int drawY = cellTop + (cellHeight + 12) / 2 - 2;
                                        u8g2Fonts.drawUTF8(cellWidth * x + marginLeft + (availW - u8g2Fonts.getUTF8Width(drawStr.c_str())) / 2, drawY, drawStr.c_str());
                }
            }

            if (pos_end < 0) break;
            pos_begin = pos_end + 1;
            yStep++;
        } while (true);
    }

}

///////////// Calendar //////////////
/**
 * 处理日历信息
 */
void si_calendar() {
    _calendar_status = 0;

    Preferences pref;
    pref.begin(PREF_NAMESPACE);
    int32_t _calendar_date = pref.getInt(PREF_SI_CAL_DATE);
    _cd_day_label = pref.getString(PREF_CD_DAY_LABLE);
    _cd_day_date = pref.getString(PREF_CD_DAY_DATE);
    _tag_days_str = pref.getString(PREF_TAG_DAYS);
    _week_1st = pref.getString(PREF_SI_WEEK_1ST, "0").toInt();
    _study_schedule = pref.getString(PREF_STUDY_SCHEDULE);
    _si_type = pref.getInt(PREF_SI_TYPE);
    if (_study_schedule.isEmpty()) _si_type = 0;

    pref.end();

    time_t now = 0;
    time(&now);
    localtime_r(&now, &tmInfo); // 时间戳转化为本地时间结构
    Serial.printf("System Time: %d-%02d-%02d %02d:%02d:%02d\n", (tmInfo.tm_year + 1900), tmInfo.tm_mon + 1, tmInfo.tm_mday, tmInfo.tm_hour, tmInfo.tm_min, tmInfo.tm_sec);

    // 如果当前时间无效
    if (tmInfo.tm_year + 1900 < 2025) {
        bool isSetOK = false;
        if (weather_status() == 1) {
            // 尝试使用api获取的时间
            String apiTime;
            Weather* weatherNow = weather_data_now();
            if (weatherNow->updateTime == NULL) {
                // TODO 处理每日天气
                DailyForecast* wFc = weather_data_daily();
                apiTime = wFc->updateTime;
            } else {
                apiTime = weatherNow->updateTime;
            }
            Serial.printf("API Time: %s\n", apiTime.c_str());
            tmInfo = { 0 }; // 重置为0
            if (strptime(apiTime.c_str(), "%Y-%m-%dT%H:%M", &tmInfo) != NULL) {  // 将时间字符串转成tm时间 e.g. 2024-11-14T17:36+08:00
                time_t set = mktime(&tmInfo);
                timeval tv;
                tv.tv_sec = set;
                isSetOK = (settimeofday(&tv, nullptr) == 0);
                Serial.println("WARN: Set system time by api time.");
            } else {
                Serial.println("ERR: Fail to format api time.");
            }
        } else {
            // 如果天气也未获取成功，那么返回
            Serial.println("ERR: invalid time & not weather info got.");
        }
        if (!isSetOK) {
            _calendar_status = 2;
            return;
        }
    }

    char buffer[64];
    strftime(buffer, sizeof(buffer), "%Y-%m-%d %H:%M:%S", &tmInfo);
    Serial.printf("Calendar Show Time: %s\n", buffer);

    nl_month_days(tmInfo.tm_year + 1900, tmInfo.tm_mon + 1, lunarDates);
    nl_year_jq(tmInfo.tm_year + 1900, jqAccDate);

    _calendar_status = 1;
    return;
}

int si_calendar_status() {
    return _calendar_status;
}

///////////// Screen //////////////
/**
 * 屏幕刷新
 */
void task_screen(void* param) {
    Serial.println("[Task] screen update begin...");

    voltage = readBatteryVoltage();

    delay(100);

    display.init(115200);          // 串口使能 初始化完全刷新使能 复位时间 ret上拉使能
    display.setRotation(ROTATION); // 设置屏幕旋转1和3是横向  0和2是纵向
    u8g2Fonts.begin(display);

    init_cal_layout_size();
    display.setFullWindow();
    display.firstPage();
    display.fillScreen(GxEPD_WHITE);
    do {
        if (_si_type == 1) {
            drawStudySchedule();
        } else {
            draw_cal_days(false);
            draw_cal_header();
        }

        draw_cal_year(false);

        // 倒计日
        draw_cd_day(_cd_day_label, _cd_day_date);

        if (weather_status() == 1) {
            draw_weather(false);
        }
        if (voltage > 1000 && voltage < 4300) {
            draw_status(false);
        }
    } while (display.nextPage());

    int32_t _calendar_date = (tmInfo.tm_year + 1900) * 10000 + (tmInfo.tm_mon + 1) * 100 + tmInfo.tm_mday;

    Preferences pref;
    pref.begin(PREF_NAMESPACE);
    pref.putInt(PREF_SI_CAL_DATE, _calendar_date);
    pref.end();

    display.powerOff();
    display.hibernate();
    Serial.println("[Task] screen update end...");

    _screen_status = 1;
    SCREEN_HANDLER = NULL;
    vTaskDelete(NULL);
}

void si_screen() {
    _screen_status = 0;
    si_calendar(); // 准备日历数据

    if (si_calendar_status() == 2) {
        Serial.println("ERR: System time prepare failed.");
        _screen_status = 2;
        return;
    }

    if (SCREEN_HANDLER != NULL) {
        vTaskDelete(SCREEN_HANDLER);
    }
    xTaskCreate(task_screen, "Screen", 4096, NULL, 2, &SCREEN_HANDLER);
}

int si_screen_status() {
    return _screen_status;
}

void print_status() {
    Serial.printf("Weather: %d\n", weather_status());
    Serial.printf("Calendar: %d\n", si_calendar_status());
    Serial.printf("Screen: %d\n", si_screen_status());
}



void si_warning(const char* str) {
    Serial.println("Screen warning...");
    display.init(115200);          // 串口使能 初始化完全刷新使能 复位时间 ret上拉使能
    display.setRotation(ROTATION); // 设置屏幕旋转1和3是横向  0和2是纵向
    u8g2Fonts.begin(display);

    display.setFullWindow();
    display.fillScreen(GxEPD_WHITE);
    do {
        u8g2Fonts.setFontMode(1);
        u8g2Fonts.setFontDirection(0);
        u8g2Fonts.setBackgroundColor(GxEPD_WHITE);
        u8g2Fonts.setForegroundColor(GxEPD_BLACK);

        u8g2Fonts.setFont(u8g2_font_open_iconic_all_4x_t);
        int space = 8;
        int w = u8g2Fonts.getUTF8Width("\u0118") + space;
        u8g2Fonts.setFont(FONT_TEXT);
        w += u8g2Fonts.getUTF8Width(str);

        u8g2Fonts.setForegroundColor(GxEPD_RED);
        u8g2Fonts.setFont(u8g2_font_open_iconic_all_4x_t);
        u8g2Fonts.setCursor((display.width() - w) / 2, (display.height() + 32) / 2);
        u8g2Fonts.print("\u0118");

        u8g2Fonts.setForegroundColor(GxEPD_BLACK);
        u8g2Fonts.setCursor(u8g2Fonts.getCursorX() + space, u8g2Fonts.getCursorY() - 8);
        u8g2Fonts.setFont(FONT_TEXT);
        u8g2Fonts.print(str);
    } while (display.nextPage());

    display.powerOff();
    display.hibernate();
}
