MYHealer/wyu-jcalendar/(commit log)

2026-05-20 README：重写，突出学习通CK自动获取课程表功能 v1.1.9.1
    [China-City-List-latest.csv, E-ink box2 v22.3mf, min_spiffs.csv]
2026-05-20 材料：金属底座亚克力台卡改为3D打印外壳
2026-05-20 Update README.md
    改了些材料上的文本描述
2026-05-20 添加学习通CK课程表测试脚本
2026-05-20 README: 添加测试工具说明
2026-05-20 README: PIN_14 改为 14
2026-05-20 README: 重写，突出学习通CK自动获取课程表功能 v1.1.9.1
2026-05-20 更新固件至 v1.1.9.1
2026-05-20 README: 润色，补充CK获取步骤、加badge、精简版权
2026-05-20 README: 合并核心功能介绍到课程表配置章节，消除重复
2026-05-20 README: 修正Alook浏览器官网链接
2026-05-21 Replace old images with new sample images
    Updated images in README to include new sample images.
